Isaacyang34/ESP32-BSB/ESP32-S3-HUB75-74HCT245/U4-U8.pdf

IO1 | 1 | 2 | TXD | IO45 | 1 | 2 | IO48
IO2 | 3 | 4 | RXD | IO46 | 3 | 4 | 3V3
IO41 | 5 | 6 | IO42 | IO47 | 5 | 6 | 5V
IO40 | 1 | 2 | IO39 | IO3 | 1 | 2 | IO13
IO38 | 3 | 4 | 3V3 | GND | 3 | 4 | IO14
5V | 5 | 6 | GND | GND | 5 | 6 | IO21

U4

U7

U8

U6
