Isaacyang34/ESP32-BSB/ESP32-S3-HUB75-74HCT245/U4.jpg

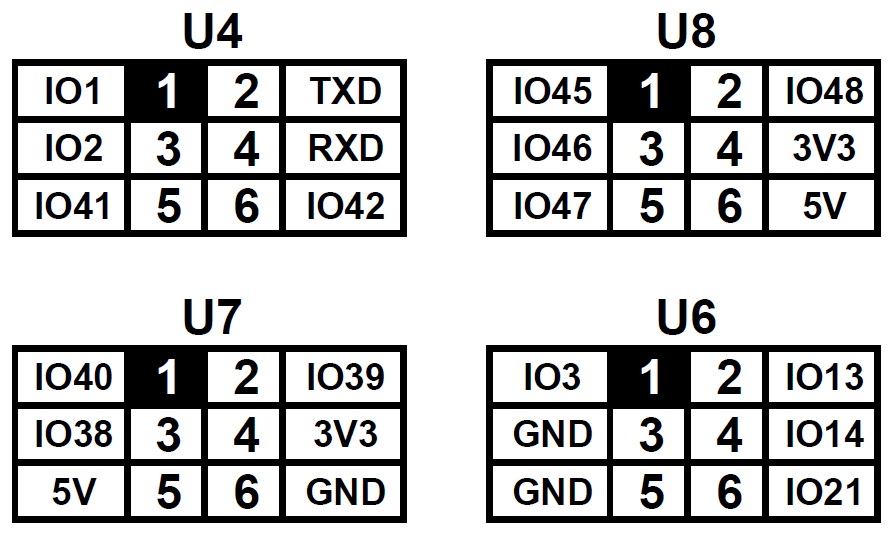
ESP32-S3-HUB75-74HCT245/U4.jpg
