Isaacyang34/ESP32-BSB/ESP32-S3-HUB75-74HCT245/瑟魯迅.jpg

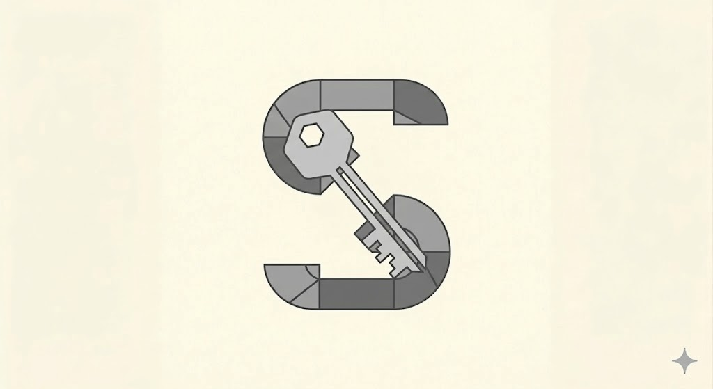
ESP32-S3-HUB75-74HCT245/瑟魯迅.jpg
