Isaacyang34/ESP32-BSB/ESP32-S3-HUB75-74HCT245/BOM_PCB_ESP32-HUB75-74hct245_2_2026-03-23.csv

ID | Name | Designator | Footprint | Quantity | Manufacturer Part | Manufacturer | Supplier | Supplier Part | Price
1 | 0.1UF-C0402 | C1,C2,C3,C4,C5 | C0402 | 5 | 0.1uF-c0402 | null | LCSC | C9900008998
2 | 10kΩ | R1,R2 | R0201 | 2 | CRCW020110K0JNED | VISHAY(威世) | LCSC | C844095 | 0.005
3 | ESP32-S3-WROOM-1U-N16R16V | U1 | WIRELM-SMD_ESP32-S3-WROOM-1U-N16R16V | 1 | ESP32-S3-WROOM-1U-N16R16V | null | LCSC | C9900222524
4 | MC74HCT245ADWR2 | U2,U3 | SOIC-20_L12.8-W7.5-P1.27-LS10.3-BL | 2 | MC74HCT245ADWR2 | onsemi(安森美) | LCSC | C3587500 | 0.309
5 | TYPE-C-31-M-37A | U4 | TYPE-C-SMD_TYPE-C-31-M-37A | 1 | TYPE-C-31-M-37A | 韩国韩荣 | LCSC | C5370438 | 0.448
6 | AMS1117-3.3-CN | U5 | SOT-223-3_L6.7-W3.7-P2.30-LS7.0-BR_2 | 1 | AMS1117-3.3-CN | ChipNobo(无边界) | LCSC | C45369270 | 0.04
7 | 10uF | U6,U7 | C1812 | 2 | C4532X7R1C106M230KA | TDK | LCSC | C3851081 | 0.296
8 | 5.1kΩ | U8,U9 | RES-TH_BD1.9-L3.5-P7.50-D0.5 | 2 | MFR-12FRF52-5K1 | YAGEO(国巨) | LCSC | C1742929 | 0.01
9 | DS-03XG-160H5 | RST,BOOT | KEY-SMD_4P-L6.0-W6.0-P4.50-LS9.5-BR | 2 | DS-03XG-160H5 | D-SWITCH(德崧) | LCSC | C5367494
10 | SH-JN2.54-2-8P-Z | CN1 | IDC-TH_SH-JN2.54-2-8P-Z | 1 | SH-JN2.54-2-8P-Z | SHOU HAN(首韩) | LCSC | C41417417 | 0.235
11 | DS1023-02-2X8SF11 | U12 | CONN-TH_DS1023-02-2X8SF11 | 1 | DS1023-02-2x8SF11 | null | LCSC | C42420228
