Isaacyang34/ESP32-BSB/ESP32-S3-HUB75-74HCT245/BOM_PCB_ESP32-HUB75-74hct245_3.3V_2026-03-31.csv

 |  |  |  | 片數 | 10 | 下單量 | 價格 | 台幣 | 4.65
ID | Name | Designator | Footprint | Quantity |  |  |  |  | Manufacturer Part | Manufacturer | Supplier | Supplier Part | Price
1 | 3P-19MM | 12,G_23,E | HDR-TH_3P-P2.54-V-M_C9900004029 | 1 | 10 | 500 | 15.77 | 73.3305 | 双塑直脚单排针 3p 19mm | null | LCSC | C9900004029
2 | DS-03XG-160H5 | BOOT,RST | KEY-SMD_4P-L6.0-W6.0-P4.50-LS9.5-BR | 2 | 20 | 20 | 10 | 46.5 | DS-03XG-160H5 | D-SWITCH(德崧) | LCSC | C5367494
3 | 500R07W104KV4T 0.1UF 50V | C1,C2,C3 | C0402 | 3 | 30 | 100 |  | 0 | 500R07W104KV4T 0.1uF 50v | null | LCSC | C5337557
4 | 10uF | C4,C5 | C0805 | 2 | 20 | 30 |  | 0 | 0805X106K6R3CT | Walsin(华新科) | LCSC | C303938
5 | 1000uF | C8 | CAP-TH_BD8.0-P3.50-D0.5-FD | 1 | 10 | 10 | 5.68 | 26.412 | CD288H1CM102F160T | 创慧电子 | LCSC | C42460484 | 0.05
6 | 22uF | C9,C10 | C1206 | 2 | 20 | 30 | 10.7 | 49.755 | CL31A226KAHNNNE | SAMSUNG(三星) | LCSC | C12891 | 0.056
7 | SS34-MS | D1 | DO-214AA_L4.3-W2.7-LS5.0-RD | 1 | 10 | 20 |  | 0 | SS34-MS | MSKSEMI(美森科) | LCSC | C2836396 | 0.018
8 | KF301R-5.0-2P | GND,VCC | CONN-TH_P5.00_KF301R-5.0-2P | 2 | 20 | 20 | 2.8 | 13.02 | KF301R-5.0-2P | KEFA(科发) | LCSC | C474883 | 0.135
9 | 白色贴片LED-0603 | IO2_LED | LED0603-RD_WHITE | 1 | 10 | 100 |  | 0 | 白色贴片LED-0603 | null | LCSC | C9900005786
10 | 2.2uH | L1 | IND-SMD_L8.0-W8.0_ZENR8040T2R2M-2.2UH | 1 | 10 | 20 | 5.6 | 26.04 | ZENR8040T2R2M-2.2uH | ZE(增益) | LCSC | C42428130 | 0.122
11 | DS1023-02-2X8SF11 | MODE-0 | CONN-TH_DS1023-02-2X8SF11 | 1 | 10 | 8 | 15.74 | 73.191 | DS1023-02-2x8SF11 | null | LCSC | C42420228
12 | SH-JN2.54-2-8P-Z | MODE-1 | IDC-TH_SH-JN2.54-2-8P-Z | 1 | 10 | 8 | 4.35 | 20.2275 | SH-JN2.54-2-8P-Z | SHOU HAN(首韩) | LCSC | C41417417 | 0.235
13 | 10kΩ | R1,R2 | R0402 | 2 | 20 | 100 | 30.8 | 143.22 | CRCW020110K0JNED | VISHAY(威世) | LCSC | C844095 | 0.005
14 | 5.1kΩ | R3,R4 | R0805 | 2 | 20 | 100 |  |  | SFR10EZPJ512 | ROHM(罗姆) | LCSC | C6216846 | 0.024
15 | 1kΩ | R5 | R0603 | 1 | 10 | 100 |  |  | CR-03JL7----1K | Viking(光颉) | LCSC | C217299 | 0.001
16 | 2.2kΩ | R6,R7 | R0603 | 2 | 20 | 100 |  |  | CR-03JL7----1K | Viking(光颉) | LCSC | C217299 | 0.001
17 | 100kΩ | R8 | R0402 | 1 | 10 | 100 |  |  | AC0402FR-7W100KL | YAGEO(国巨) | LCSC | C850721 | 0.003
18 | 22.1kΩ | R9 | R0402 | 1 | 10 | 100 |  |  | ERJ2RKF2212X | PANASONIC(松下) | LCSC | C2076799 | 0.004
19 | 绿色LED0603 | RX_LED | LED0603-RD_GREEN | 1 | 10 | 100 |  |  | 绿色LED0603 | null | LCSC | C9900005570
20 | 红色贴片LED-0603 | TX_LED | LED0603-RD_RED | 1 | 10 | 100 |  |  | 红色贴片LED-0603 | null | LCSC | C9900005785
21 | TYPE-C-31-M-37A | TYPE-C | TYPE-C-SMD_TYPE-C-31-M-37A | 1 | 10 | 10 | 4.5 | 20.925 | TYPE-C-31-M-37A | 韩国韩荣 | LCSC | C5370438 | 0.448
22 | ESP32-S3-WROOM-1(N16R8) | U1 | WIRELM-SMD_ESP32-S3-WROOM-1 | 1 | 10 | 10 | 182.6 | 849.09 | ESP32-S3-WROOM-1-N16R8 | ESPRESSIF(乐鑫) | LCSC | C2913202 | 5.27
23 | MC74HCT245ADWR2 | U2,U3 | SOIC-20_L12.8-W7.5-P1.27-LS10.3-BL | 2 | 20 | 20 | 62.6 | 291.09 | MC74HCT245ADWR2 | onsemi(安森美) | LCSC | C3587500 | 0.309
24 | 146268-3 | U4,U6,U7,U8 | HDR-TH_6P-P2.54-V-M-R2-C3-S2.54-3 | 4 | 40 |  |  | 0 | 146268-3 | TE Connectivity(泰科电子) | LCSC | C5475870 | 1.87
25 | SY8089AABC | U11 | SOT-23-5_L3.0-W1.6-P0.95-LS2.8-BL | 1 | 10 | 10 | 6.45 | 29.9925 | SY8089AABC | null | LCSC | C9900000888
 |  |  |  |  |  |  |  | 1662.7935
