Isaacyang34/ESP32-BSB/BOM_PCB_ESP32_30pin-HUB75-10k_3.3V_2_2026-03-18.csv

ID | Name | Designator | Footprint | Quantity | Manufacturer Part | Manufacturer | Supplier | Supplier Part | Price | Pins | 3DModel | Contributor | JLCPCB Part Class | link
1 | HDR-IDC-2.54-2X8P | P1 | IDC-TH_16P-P2.54_C3406 | 1 | 2.54-2*8P简牛 | BOOMELE(博穆精密) | LCSC | C3406 | 0.103 | 16 | IDC-TH_16P-P2.54-V-R2-C8-S2.54 | lcsc | Extended Part | https://lcsc.com/eda_search?q=C3406&%26type=1&ref=editor
2 | 10k | R1 | R0603 | 1 |  |  |  |  |  | 2 | R0603 | LCEDA_Lib |  | https://www.mouser.in/datasheet/2/447/PYu_RT_1_to_0_01_RoHS_L_11-1669912.pdf
3 | 10k | R2 | R_AXIAL-0.3 | 1 |  |  |  |  |  | 2 | R_AXIAL-0.3 | LCEDA_Lib
4 | PM2.54-1*15 | U1,U2 | HDR-TH_15P-P2.54-V-F | 2 | PM2.54-1*15 | ZHOURI(洲日) | LCSC | C5371989 | 0.177 | 15 | HDR-TH_15P-P2.54-V-F | lcsc | Extended Part | https://lcsc.com/eda_search?q=C5371989&%26type=1&ref=editor
5 | KF301-5.0-2P | U3 | CONN-TH_P5.00_KF301-5.0-2P | 1 | KF301-5.0-2P | KEFA(科发) | LCSC | C474881 | 0.091 | 2 | CONN-TH_P5.00_KF301-5.0-2P | LCSC | Extended Part | https://lcsc.com/eda_search?q=C474881&%26type=1&ref=editor
