Isaacyang34/ESP32-BSB/ESP32-S3-HUB75-74HCT245/Schematic_ESP32-HUB75-74hct245-SY8089_2026-03-31.pdf

IO0 27 IO35 28 IO36 29 IO37 30 IO38 31 IO39 32 IO40 33 IO41 34 IO42 35 RXD0 36 TXD0 37 IO2 38 IO1 39 GND 40

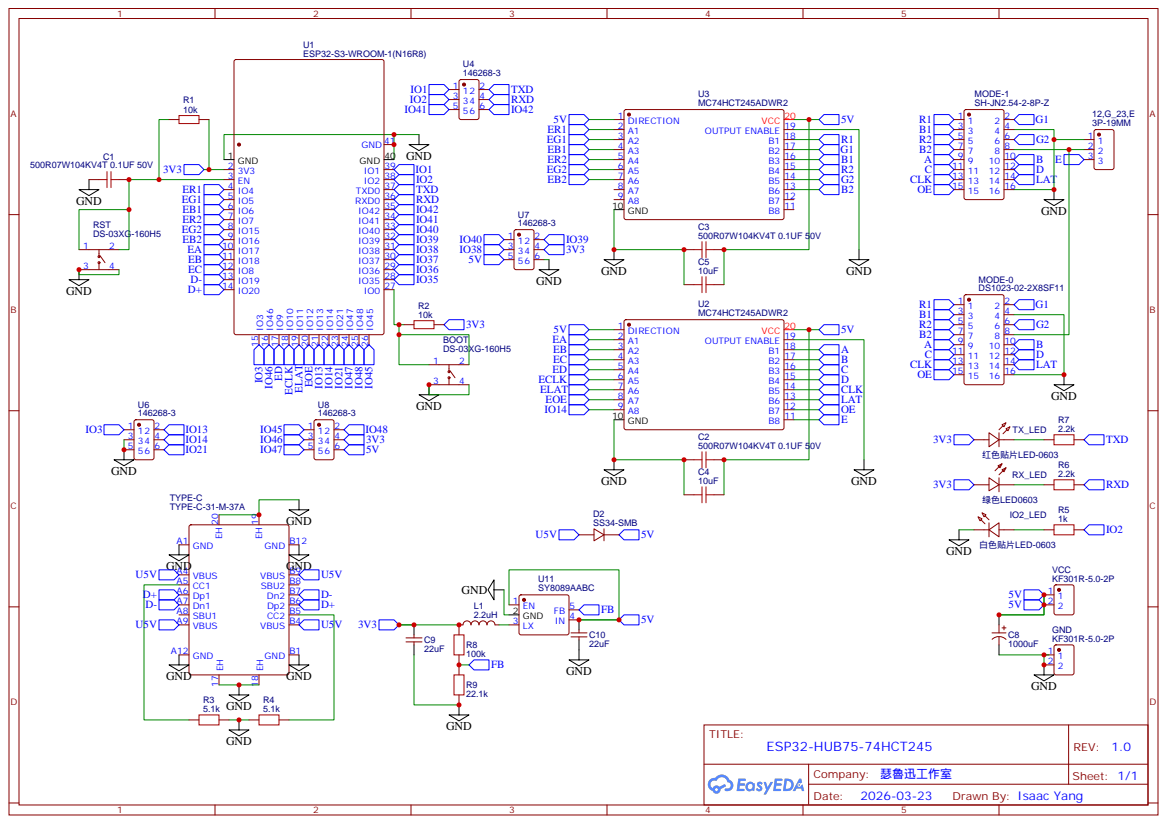
[picture p3: page 1]

Drawn By: Isaac Yang
