Isaacyang34/ESP32-BSB/(commit log)

2026-05-17 Refactor: Integrate Setup Mode, AnimatedGIF, BLE, and Voice control into single esp32.ino
2026-05-18 Refine Voice UI: shrink button and persist previous command log
2026-05-21 chore: reorganize folder structure and move esp32.ino to subfolder
    [BOM_PCB_ESP32-HUB75-74hct245_2_2026-03-23.csv, BOM_PCB_ESP32-HUB75-74hct245_3.3V_2026-03-31.csv, PickAndPlace_PCB_ESP32-HUB75-74hct245_2_2026-03-23.csv]
